EnzoPerrier/BancTestEL418-Electronique/CA/BANC_TEST_418/Note.txt

CHANGER TRANSISTOR COMMANDE BUZZER
ADM3232 à la place du MAX3232
