EnzoPerrier/BancTestEL418-Electronique/BANC_TEST_418-JLCPCB Assembly Order.xls

JLCPCB BOM Tool - BOM Matching
BOM name：BANC_TEST_418-JLCPCB Assembly Order.xlsx |  |  | Download Time：2025-05-28 04:37:29 |  |  |  | * Our matching results are updated in real-time, but stock and prices may change. If it's been over 24 hours, please re-match before placing your order.
PCB Assembled Qty：5 |  |  | Est. Total Price：3.9750
Your BOM |  |  |  |  | Matched Parts |  |  |  |  |  |  | Order Information
Top Designator | Bottom Designator | Comment | Footprint | JLCPCB Part # | Matches | Part # | Manufacturer | Footprint | Description | Category | Warning | JLCPCB Part # | Product link | Lib Type | Qty | Source | Total Price ($)
C1,C2 |  | 27pF | C0805_2012Metric_Pad1.18x1.45mm_HandSolder |  | Select by System | 0805CG270J500NT | FH (Guangdong Fenghua Advanced Tech) | 0805 | 50V 27pF C0G ±5% 0805 Multilayer Ceramic Capacitors MLCC - SMD/SMT ROHS | Multilayer Ceramic Capacitors MLCC - SMD/SMT |  | C1808 | https://jlcpcb.com/partdetail/2160-0805CG270J500NT/C1808 | Extended | 0 | 0 JLCPCB | 0
C3,C14,C16,C23,C24,C26,C27,C28,C29 |  | 100nF | C0805_2012Metric_Pad1.18x1.45mm_HandSolder |  | Select by System | CC0805KRX7R9BB104 | YAGEO | 0805 | 50V 100nF X7R ±10% 0805 Multilayer Ceramic Capacitors MLCC - SMD/SMT ROHS | Multilayer Ceramic Capacitors MLCC - SMD/SMT |  | C49678 | https://jlcpcb.com/partdetail/YAGEO-CC0805KRX7R9BB104/C49678 | Basic | 75 | 75 JLCPCB | 0.33
C4,C9,C15,C17,C18,C19 |  | 100nF | C0805_2012Metric_Pad1.18x1.45mm_HandSolder |  | Select by System | CC0805KRX7R9BB104 | YAGEO | 0805 | 50V 100nF X7R ±10% 0805 Multilayer Ceramic Capacitors MLCC - SMD/SMT ROHS | Multilayer Ceramic Capacitors MLCC - SMD/SMT |  | C49678 | https://jlcpcb.com/partdetail/YAGEO-CC0805KRX7R9BB104/C49678 | Basic | 75 | 75 JLCPCB | 0.33
C6 |  | 4.7uF | C0805_2012Metric_Pad1.18x1.45mm_HandSolder |  | Select by System | CL21A475KAQNNNE | Samsung Electro-Mechanics | 0805 | 25V 4.7uF X5R ±10% 0805 Multilayer Ceramic Capacitors MLCC - SMD/SMT ROHS | Multilayer Ceramic Capacitors MLCC - SMD/SMT |  | C1779 | https://jlcpcb.com/partdetail/2131-CL21A475KAQNNNE/C1779 | Basic | 5 | 5 JLCPCB | 0.0575
C7 |  | 470nF | C0805_2012Metric_Pad1.18x1.45mm_HandSolder |  | Select by System | CL21B474KBFNNNE | Samsung Electro-Mechanics | 0805 | 50V 470nF X7R ±10% 0805 Multilayer Ceramic Capacitors MLCC - SMD/SMT ROHS | Multilayer Ceramic Capacitors MLCC - SMD/SMT |  | C13967 | https://jlcpcb.com/partdetail/14623-CL21B474KBFNNNE/C13967 | Basic | 5 | 5 JLCPCB | 0.064
C10 |  | 47uF | C0805_2012Metric_Pad1.18x1.45mm_HandSolder |  | Select by System | CL21A476MQYNNNE | Samsung Electro-Mechanics | 0805 | 6.3V 47uF X5R ±20% 0805 Multilayer Ceramic Capacitors MLCC - SMD/SMT ROHS | Multilayer Ceramic Capacitors MLCC - SMD/SMT |  | C16780 | https://jlcpcb.com/partdetail/17464-CL21A476MQYNNNE/C16780 | Basic | 5 | 5 JLCPCB | 0.15
C11 |  | 1nF | C0805_2012Metric_Pad1.18x1.45mm_HandSolder |  | Select by System | CL21B102KBCNNNC | Samsung Electro-Mechanics | 0805 | 50V 1nF X7R ±10% 0805 Multilayer Ceramic Capacitors MLCC - SMD/SMT ROHS | Multilayer Ceramic Capacitors MLCC - SMD/SMT |  | C46653 | https://jlcpcb.com/partdetail/47657-CL21B102KBCNNNC/C46653 | Basic | 5 | 5 JLCPCB | 0.04
C12 |  | 47pF | C0805_2012Metric_Pad1.18x1.45mm_HandSolder |  | Select by System | CL21C470JBANNNC | Samsung Electro-Mechanics | 0805 | 50V 47pF C0G ±5% 0805 Multilayer Ceramic Capacitors MLCC - SMD/SMT ROHS | Multilayer Ceramic Capacitors MLCC - SMD/SMT |  | C14857 | https://jlcpcb.com/partdetail/15529-CL21C470JBANNNC/C14857 | Basic | 5 | 5 JLCPCB | 0.0555
C13 |  | 15nF | C0805_2012Metric_Pad1.18x1.45mm_HandSolder |  | Select by System | CC0805KRX7R9BB153 | YAGEO | 0805 | 50V 15nF X7R ±10% 0805 Multilayer Ceramic Capacitors MLCC - SMD/SMT ROHS | Multilayer Ceramic Capacitors MLCC - SMD/SMT |  | C107143 | https://jlcpcb.com/partdetail/YAGEO-CC0805KRX7R9BB153/C107143 | Extended | 0 | 0 JLCPCB | 0
C20,C21,C22,C25 |  | 1uF | C0805_2012Metric_Pad1.18x1.45mm_HandSolder |  | Select by System | CL21B105KBFNNNE | Samsung Electro-Mechanics | 0805 | 50V 1uF X7R ±10% 0805 Multilayer Ceramic Capacitors MLCC - SMD/SMT ROHS | Multilayer Ceramic Capacitors MLCC - SMD/SMT |  | C28323 | https://jlcpcb.com/partdetail/29074-CL21B105KBFNNNE/C28323 | Basic | 20 | 20 JLCPCB | 0.186
D1 |  | 1N4742A | D_DO-41_SOD81_P10.16mm_Horizontal |  | Select by System | 1N4742A | onsemi | 插件,D2.03xL4.06mm | Independent Type 11.4V~12.6V 1W 12V Plugin,D2.03xL4.06mm Zener Diodes ROHS | Zener Diodes |  | C140853 | https://jlcpcb.com/partdetail/onsemi-1N4742A/C140853 | Extended | 7 | 7 JLCPCB | 0.455
D2 |  | MBRA340 | D_SMA |  | Unconfirmed | MBRA340T3G | Tokmas | DO-214AC | 40V 450mV 3A DO-214AC Schottky Diodes ROHS | Schottky Diodes | 1.The comment (MBRA340T3G) of this part does not match the one (MBRA340) provided in your BOM. Please confirm; | C5337991 | https://jlcpcb.com/partdetail/Tokmas-MBRA340T3G/C5337991 | Extended | 0 | 0 JLCPCB | 0
D3,D6,D7,D8 |  | SM4007 | D_MELF |  | Select by System | SM4007 | YFW | DO-213AB | 1A 1V@1A 1000V 2uA@1000V DO-213AB Diodes - General Purpose | Diodes - General Purpose |  | C41433819 | https://jlcpcb.com/partdetail/YFW-SM4007/C41433819 | Extended | 0 | 0 JLCPCB | 0
D4 |  | PESD3V3L4UG | SOT-353_SC-70-5 |  | Select by System | PESD3V3L4UG | TECH PUBLIC | SOT-353 | SOT-353 ESD and Surge Protection (TVS/ESD) ROHS | ESD And Surge Protection (TVS/ESD) |  | C3021134 | https://jlcpcb.com/partdetail/TECHPUBLIC-PESD3V3L4UG/C3021134 | Extended | 0 | 0 JLCPCB | 0
JUMP1 |  | JUMPER | PinHeader_1x02_P1.00mm_Vertical |  | Unconfirmed | Jumper2 | Wurth Elektronik | HDR-TH_2P-P2.54-L5.1-W2.5 | Wurth Elektronik Jumper2 |  | 1.The comment (Jumper2) of this part does not match the one (JUMPER) provided in your BOM. Please confirm; | C2940092 | https://jlcpcb.com/partdetail/WurthElektronik-Jumper2/C2940092 | Extended | 0 | 0 JLCPCB | 0
Q1,Q3,Q4,Q5,Q6,Q7,Q9,Q10,Q11,Q12 |  | BSS138 | SOT95P240X111-3N |  | Select by System | BSS138 | hongjiacheng | SOT-23 | 50V 340mA 2.5Ω@10V,0.34A 350mW 1.6V@250uA 1PCSNChannel SOT-23 MOSFETs ROHS | MOSFETs |  | C7420339 | https://jlcpcb.com/partdetail/hongjiacheng-BSS138/C7420339 | Extended | 0 | 0 JLCPCB | 0
Q2 |  | IRF9540N | TO-263-2 |  | Unconfirmed | IRF9540NSTRLPBF | Infineon Technologies | D2PAK | 100V 23A 117mΩ@10V,14A 4V@250uA 1 Piece P-Channel D2PAK MOSFETs ROHS | MOSFETs | 1.The comment (IRF9540NSTRLPBF) of this part does not match the one (IRF9540N) provided in your BOM. Please confirm; | C33903 | https://jlcpcb.com/partdetail/InfineonTechnologies-IRF9540NSTRLPBF/C33903 | Extended | 0 | 0 JLCPCB | 0
Q8 |  | PS302 | LED_D5.0mm_Clear |  | Unconfirmed | 1PS302,115 | Nexperia | SOT-323 | 80V 1 pair in series 1.2V@100mA 4ns 200mA SOT-323 Switching Diodes ROHS | Switching Diodes | 1.The comment (1PS302,115) of this part does not match the one (PS302) provided in your BOM. Please confirm; | C192740 | https://jlcpcb.com/partdetail/Nexperia-1PS302115/C192740 | Extended | 0 | 0 JLCPCB | 0
R1,R2,R3,R5,R6,R7,R21,R24,R28,R31 |  | 10k | R0805_2012Metric_Pad1.20x1.40mm_HandSolder |  | Unconfirmed | 0805W8F1002T5E | UNI-ROYAL(Uniroyal Elec) | 0805 | 125mW Thick Film Resistors 150V ±100ppm/℃ ±1% 10kΩ 0805 Chip Resistor - Surface Mount ROHS | Chip Resistor - Surface Mount | 1.The comment (0805W8F1002T5E) of this part does not match the one (10k) provided in your BOM. Please confirm; | C17414 | https://jlcpcb.com/partdetail/18102-0805W8F1002T5E/C17414 | Basic | 50 | 50 JLCPCB | 0.085
R4,R8 |  | 4.7k | R0805_2012Metric_Pad1.20x1.40mm_HandSolder |  | Unconfirmed | 0805W8F4701T5E | UNI-ROYAL(Uniroyal Elec) | 0805 | 125mW Thick Film Resistors 150V ±100ppm/℃ ±1% 4.7kΩ 0805 Chip Resistor - Surface Mount ROHS | Chip Resistor - Surface Mount | 1.The comment (0805W8F4701T5E) of this part does not match the one (4.7k) provided in your BOM. Please confirm; 2.Multiple lines in the BOM have been matched to the same part. Please check if the matching is correct. ; | C17673 | https://jlcpcb.com/partdetail/18361-0805W8F4701T5E/C17673 | Basic | 15 | 15 JLCPCB | 0.0255
R9 |  | 4k7 | R0805_2012Metric_Pad1.20x1.40mm_HandSolder |  | Unconfirmed | 0805W8F4701T5E | UNI-ROYAL(Uniroyal Elec) | 0805 | 125mW Thick Film Resistors 150V ±100ppm/℃ ±1% 4.7kΩ 0805 Chip Resistor - Surface Mount ROHS | Chip Resistor - Surface Mount | 1.The comment (0805W8F4701T5E) of this part does not match the one (4k7) provided in your BOM. Please confirm; 2.Multiple lines in the BOM have been matched to the same part. Please check if the matching is correct. ; | C17673 | https://jlcpcb.com/partdetail/18361-0805W8F4701T5E/C17673 | Basic | 15 | 15 JLCPCB | 0.0255
R10,R17,R18,R32,R33,R34,R35,R36,R37,R38,R41,R47,R48,R49,R50 |  | 100 | R0805_2012Metric_Pad1.20x1.40mm_HandSolder |  | Unconfirmed | 0805W8F1000T5E | UNI-ROYAL(Uniroyal Elec) | 0805 | 125mW Thick Film Resistors 150V ±100ppm/℃ ±1% 100Ω 0805 Chip Resistor - Surface Mount ROHS | Chip Resistor - Surface Mount | 1.The comment (0805W8F1000T5E) of this part does not match the one (100) provided in your BOM. Please confirm; | C17408 | https://jlcpcb.com/partdetail/18096-0805W8F1000T5E/C17408 | Basic | 75 | 75 JLCPCB | 0.135
R11 |  | 332k1% | R0805_2012Metric_Pad1.20x1.40mm_HandSolder |  | Unconfirmed | FRC0805F3323TS | FOJAN | 0805 | 125mW Thick Film Resistors 150V ±100ppm/℃ ±1% 332kΩ 0805 Chip Resistor - Surface Mount ROHS | Chip Resistor - Surface Mount | 1.The comment (FRC0805F3323TS) of this part does not match the one (332k1%) provided in your BOM. Please confirm; | C5713304 | https://jlcpcb.com/partdetail/FOJAN-FRC0805F3323TS/C5713304 | Extended | 0 | 0 JLCPCB | 0
R12 |  | 68.1k1% | R0805_2012Metric_Pad1.20x1.40mm_HandSolder |  | Unconfirmed | ARG05FTC6812 | Viking Tech | 0805 | 125mW Thin Film Resistor 150V ±25ppm/℃ ±1% 68.1kΩ 0805 Chip Resistor - Surface Mount ROHS | Chip Resistor - Surface Mount | 1.The comment (ARG05FTC6812) of this part does not match the one (68.1k1%) provided in your BOM. Please confirm; | C2831652 | https://jlcpcb.com/partdetail/VikingTech-ARG05FTC6812/C2831652 | Extended | 0 | 0 JLCPCB | 0
R13 |  | 220 | R0805_2012Metric_Pad1.20x1.40mm_HandSolder |  | Unconfirmed | 0805W8F2200T5E | UNI-ROYAL(Uniroyal Elec) | 0805 | 125mW Thick Film Resistors 150V ±100ppm/℃ ±1% 220Ω 0805 Chip Resistor - Surface Mount ROHS | Chip Resistor - Surface Mount | 1.The comment (0805W8F2200T5E) of this part does not match the one (220) provided in your BOM. Please confirm; | C17557 | https://jlcpcb.com/partdetail/18245-0805W8F2200T5E/C17557 | Basic | 5 | 5 JLCPCB | 0.0095
R14 |  | 10.2k1% | R0805_2012Metric_Pad1.20x1.40mm_HandSolder |  | Unconfirmed | FRC0805F1022TS | FOJAN | 0805 | 125mW Thick Film Resistors 150V ±100ppm/℃ ±1% 10.2kΩ 0805 Chip Resistor - Surface Mount ROHS | Chip Resistor - Surface Mount | 1.The comment (FRC0805F1022TS) of this part does not match the one (10.2k1%) provided in your BOM. Please confirm; | C2933282 | https://jlcpcb.com/partdetail/FOJAN-FRC0805F1022TS/C2933282 | Extended | 0 | 0 JLCPCB | 0
R15 |  | 3.24k1% | R0805_2012Metric_Pad1.20x1.40mm_HandSolder |  | Unconfirmed | FRC0805F3241TS | FOJAN | 0805 | 125mW Thick Film Resistors 150V ±100ppm/℃ ±1% 3.24kΩ 0805 Chip Resistor - Surface Mount ROHS | Chip Resistor - Surface Mount | 1.The comment (FRC0805F3241TS) of this part does not match the one (3.24k1%) provided in your BOM. Please confirm; | C2933414 | https://jlcpcb.com/partdetail/FOJAN-FRC0805F3241TS/C2933414 | Extended | 0 | 0 JLCPCB | 0
R16 |  | 29.4k | R0805_2012Metric_Pad1.20x1.40mm_HandSolder |  | Unconfirmed | FRC0805F2942TS | FOJAN | 0805 | 125mW Thick Film Resistors 150V ±100ppm/℃ ±1% 29.4kΩ 0805 Chip Resistor - Surface Mount ROHS | Chip Resistor - Surface Mount | 1.The comment (FRC0805F2942TS) of this part does not match the one (29.4k) provided in your BOM. Please confirm; | C5121537 | https://jlcpcb.com/partdetail/FOJAN-FRC0805F2942TS/C5121537 | Extended | 0 | 0 JLCPCB | 0
R19,R20,R22,R23,R26,R27,R29,R30 |  | 200 | R0805_2012Metric_Pad1.20x1.40mm_HandSolder |  | Unconfirmed | 0805W8F2000T5E | UNI-ROYAL(Uniroyal Elec) | 0805 | 125mW Thick Film Resistors 150V ±100ppm/℃ ±1% 200Ω 0805 Chip Resistor - Surface Mount ROHS | Chip Resistor - Surface Mount | 1.The comment (0805W8F2000T5E) of this part does not match the one (200) provided in your BOM. Please confirm; | C17540 | https://jlcpcb.com/partdetail/18228-0805W8F2000T5E/C17540 | Basic | 40 | 40 JLCPCB | 0.072
R25 |  | 68 | R0805_2012Metric_Pad1.20x1.40mm_HandSolder |  | Unconfirmed | 0805W8F680JT5E | UNI-ROYAL(Uniroyal Elec) | 0805 | 125mW Thick Film Resistors 150V ±1% ±200ppm/℃ 68Ω 0805 Chip Resistor - Surface Mount ROHS | Chip Resistor - Surface Mount | 1.The comment (0805W8F680JT5E) of this part does not match the one (68) provided in your BOM. Please confirm; | C17802 | https://jlcpcb.com/partdetail/18490-0805W8F680JT5E/C17802 | Extended | 0 | 0 JLCPCB | 0
R39 |  | 120 | R0805_2012Metric_Pad1.20x1.40mm_HandSolder |  | Unconfirmed | 0805W8F1200T5E | UNI-ROYAL(Uniroyal Elec) | 0805 | 125mW Thick Film Resistors 150V ±100ppm/℃ ±1% 120Ω 0805 Chip Resistor - Surface Mount ROHS | Chip Resistor - Surface Mount | 1.The comment (0805W8F1200T5E) of this part does not match the one (120) provided in your BOM. Please confirm; | C17437 | https://jlcpcb.com/partdetail/18125-0805W8F1200T5E/C17437 | Basic | 5 | 5 JLCPCB | 0.009
R40 |  | 47k | R0805_2012Metric_Pad1.20x1.40mm_HandSolder |  | Unconfirmed | 0805W8F4702T5E | UNI-ROYAL(Uniroyal Elec) | 0805 | 125mW Thick Film Resistors 150V ±100ppm/℃ ±1% 47kΩ 0805 Chip Resistor - Surface Mount ROHS | Chip Resistor - Surface Mount | 1.The comment (0805W8F4702T5E) of this part does not match the one (47k) provided in your BOM. Please confirm; | C17713 | https://jlcpcb.com/partdetail/18401-0805W8F4702T5E/C17713 | Basic | 5 | 5 JLCPCB | 0.009
R42 |  | 0.11% | R_2512_6332Metric_Pad1.40x3.35mm_HandSolder |  | Unconfirmed | RMC040230.11%N | TyoHM | 0402 | 62.5mW ±1% 30.1Ω 0402 Chip Resistor - Surface Mount ROHS | Chip Resistor - Surface Mount | 1.The comment (RMC040230.11%N) of this part does not match the one (0.11%) provided in your BOM. Please confirm; | C269647 | https://jlcpcb.com/partdetail/TyoHM-RMC040230_11N/C269647 | Extended | 0 | 0 JLCPCB | 0
R43,R44,R45 |  | 500 | R0805_2012Metric_Pad1.20x1.40mm_HandSolder |  | Unconfirmed | ARG05FTC5000 | Viking Tech | 0805 | 125mW Thin Film Resistor 150V ±25ppm/℃ ±1% 500Ω 0805 Chip Resistor - Surface Mount ROHS | Chip Resistor - Surface Mount | 1.The comment (ARG05FTC5000) of this part does not match the one (500) provided in your BOM. Please confirm; | C2828857 | https://jlcpcb.com/partdetail/VikingTech-ARG05FTC5000/C2828857 | Extended | 0 | 0 JLCPCB | 0
R46 |  | 470 | R0805_2012Metric_Pad1.20x1.40mm_HandSolder |  | Unconfirmed | 0805W8F4700T5E | UNI-ROYAL(Uniroyal Elec) | 0805 | 125mW Thick Film Resistors 150V ±100ppm/℃ ±1% 470Ω 0805 Chip Resistor - Surface Mount ROHS | Chip Resistor - Surface Mount | 1.The comment (0805W8F4700T5E) of this part does not match the one (470) provided in your BOM. Please confirm; | C17710 | https://jlcpcb.com/partdetail/18398-0805W8F4700T5E/C17710 | Basic | 5 | 5 JLCPCB | 0.009
U1 |  | STM32F103C8Tx | LQFP-48_7x7mm_P0.5mm |  | Select by System | STM32F103C8T6 | STMicroelectronics | LQFP-48(7x7) | 64KB 2V~3.6V ARM-M3 20KB 72MHz FLASH 37 LQFP-48(7x7) Microcontrollers (MCU/MPU/SOC) ROHS | Microcontrollers (MCU/MPU/SOC) |  | C8734 | https://jlcpcb.com/partdetail/STMicroelectronics-STM32F103C8T6/C8734 | Extended | 0 | 0 JLCPCB | 0
U2 |  | TPS3825-33QDBVRQ1 | TPS3825-SOT95P280X145-5N |  | Select by System | TPS3825-33QDBVRQ1 | Texas Instruments | SOT-23-5 | 120ms Active Low 1 SOT-23-5 Supervisor and Reset ICs ROHS | Supervisor And Reset ICs |  | C702194 | https://jlcpcb.com/partdetail/TexasInstruments-TPS382533QDBVRQ1/C702194 | Extended | 0 | 0 JLCPCB | 0
U6 |  | MAX3485 | SOIC-8_3.9x4.9mm_P1.27mm |  | Unconfirmed | MAX3485EIM/TR | HGSEMI | SOP-8 | SOP-8 RS-485 / RS-422 ICs ROHS | RS-485 / RS-422 ICs | 1.The comment (MAX3485EIM/TR) of this part does not match the one (MAX3485) provided in your BOM. Please confirm; | C519082 | https://jlcpcb.com/partdetail/HGSEMI-MAX3485EIMTR/C519082 | Extended | 0 | 0 JLCPCB | 0
U7 |  | MAX3232 | SOIC-16W_7.5x10.3mm_P1.27mm |  | Unconfirmed | MAX3232ESE+T | Analog Devices Inc./Maxim Integrated | SOIC-16 | 250Kbps Transceiver 2/2 SOIC-16 RS232 ICs ROHS | RS232 ICs | 1.The comment (MAX3232ESE+T) of this part does not match the one (MAX3232) provided in your BOM. Please confirm; | C15846 | https://jlcpcb.com/partdetail/16528-MAX3232ESET/C15846 | Extended | 0 | 0 JLCPCB | 0
Y1 |  | ABL-8.000MHZ-B2 | Crystal_SMD_HC49-SD_HandSoldering |  | Select by System | ABL-8.000MHZ-B2 | Abracon LLC | HC-49US | 8MHz 18pF ±20ppm ±50ppm HC-49US Crystals ROHS | Crystals |  | C7060573 | https://jlcpcb.com/partdetail/AbraconLLC-ABL_8_000MHZB2/C7060573 | Extended | 5 | 5 JLCPCB | 1.9275
C5 |  | 470uF | C_Elec_10x10.2 |  | Select by System | 470uF | HEADCON | 470uF-16V 6.3x8mm | HEADCON 470uF |  |  | C22383481 | https://jlcpcb.com/partdetail/HEADCON-470uF/C22383481 | Extended | 5 | 0 JLCPCB | 0
C8 |  | 100uF | C_Elec_10x10.2 |  | Select by System | 100uF | PANASONIC | CAP-SMD | PANASONIC 100uF |  |  | C20618601 | https://jlcpcb.com/partdetail/PANASONIC-100uF/C20618601 | Extended | 5 | 0 JLCPCB | 0
D9,D10 |  | SMAJ5.0CA | D_SMA |  | Select by System | SMAJ5.0CA | RealChip | SMA(DO-214AC) | RealChip SMAJ5.0CA |  |  | C6937207 | https://jlcpcb.com/partdetail/RealChip-SMAJ50CA/C6937207 | Extended | 12 | 0 JLCPCB | 0
K1,K2,K3,K4 |  | RT314A12 | Relay_SPDT_Schrack-RT1-16A-FormC_RM5mm |  | Select by System | RT314A12 | TE Connectivity | 插件 | 16A 400V@AC 12V SPDT (1 Form C) Plugin Magnetic Latching Relays ROHS | Magnetic Latching Relays |  | C1562830 | https://jlcpcb.com/partdetail/TEConnectivity-RT314A12/C1562830 | Extended | 20 | 0 JLCPCB | 0
U3 |  | TPS54231DRG4 | SOIC127P599X175-8N |  | Select by System | TPS54231DRG4 | Texas Instruments | SOIC-8 | Step-down type Adjustable 800mV~25V 2A 3.5V~28V SOIC-8 DC-DC Converters ROHS | DC-DC Converters |  | C3199747 | https://jlcpcb.com/partdetail/TexasInstruments-TPS54231DRG4/C3199747 | Extended | 5 | 0 JLCPCB | 0
U4,U5 |  | TCMT4106 | SOP-16_4.4x10.4mm_P1.27mm |  | Select by System | TCMT4106 | Vishay Intertech | SOIC-16 | SOIC-16 Transistor, Photovoltaic Output Optoisolators ROHS | Transistor, Photovoltaic Output Optoisolators |  | C5722208 | https://jlcpcb.com/partdetail/VishayIntertech-TCMT4106/C5722208 | Extended | 10 | 0 JLCPCB | 0
U8 |  | HTU21D | QFN100P300X300X100-7N |  | Select by System | HTU21D | TE Connectivity | DFN-6-EP(3x3) | DFN-6-EP(3x3) Temperature and Humidity Sensor ROHS | Temperature And Humidity Sensor |  | C83479 | https://jlcpcb.com/partdetail/TEConnectivity-HTU21D/C83479 | Extended | 5 | 0 JLCPCB | 0
BZ1 |  | Buzzer | Buzzer_15x7.5RM7.6 |  | No matches | No Part Selected
D5 |  | LEDVerte5mm | LED_D5.0mm |  | No matches | No Part Selected
J1 |  | Conn_01x10_Pin | PinHeader_1x10_P2.54mm_Vertical |  | No matches | No Part Selected
J2 |  | Conn_01x04_Pin | PhoenixContact_MCV_1,5_4-G-3.81_1x04_P3.81mm_Vertical |  | No matches | No Part Selected
J3 |  | Conn_01x08_Pin | PhoenixContact_MCV_1,5_8-G-3.81_1x08_P3.81mm_Vertical |  | No matches | No Part Selected
J4,J5 |  | Conn_01x06_Pin | PhoenixContact_MCV_1,5_6-G-3.81_1x06_P3.81mm_Vertical |  | No matches | No Part Selected
J6 |  | Conn_01x11_Pin_418 | PhoenixContact_MSTBVA_2,5_11-G-5,08_1x11_P5.08mm_Vertical |  | No matches | No Part Selected
J7,J11 |  | Conn_01x05_Pin | PhoenixContact_MCV_1,5_5-G-3.81_1x05_P3.81mm_Vertical |  | No matches | No Part Selected
J8 |  | DE9_Socket | DSUB-9_Socket_Horizontal_P2.77x2.84mm_EdgePinOffset9.40mm |  | No matches | No Part Selected
J9 |  | Conn_01x09_Pin_418 | PhoenixContact_MCV_1,5_9-G-3.81_1x09_P3.81mm_Vertical |  | No matches | No Part Selected
J10 |  | Conn_01x04_Pin | NS-Tech_Grove_1x04_P2mm_Vertical |  | No matches | No Part Selected
L1 |  | 10uH | L_Coilcraft_MSS1260-XXX |  | No matches | No Part Selected
SW1 |  | SW_DIP_x01 | SW_DIP_SPSTx01_Slide_9.78x4.72mm_W8.61mm_P2.54mm |  | No matches | No Part Selected
SW2 |  | SW_DIP_x03 | SW_DIP_SPSTx03_Slide_Omron_A6S-310x_W8.9mm_P2.54mm |  | No matches | No Part Selected
SW3 |  | SW_Push | SW_SPST_Omron_B3FS-100xP |  | No matches | No Part Selected
U9 |  | INA219AxDCN | SOT-23-8 |  | No matches | No Part Selected
