EnzoPerrier/BancTestEL418-Electronique/CA/Archives/BANC_TEST_418_V1/Note.txt

Rs232 (MAX232) : les condensateurs sont des charges pompes et permettent de creer du +/-12V grâce à du 5V

MAX485: DE = HIGH et RE = LOW permettent l'émission des données
	DE = LOW et RE = LOW permettent la réception des données

L1: Prendre coilcraft MSS1260-103NLD https://www.coilcraft.com/en-us/products/power/shielded-inductors/ferrite-drum/mss-mos/mss1260/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
C4 (condo polarisé): https://fr.rs-online.com/web/p/condensateurs-electrolytiques-aluminium/5370528?gb=s
R42 (résistance de shunt):https://www.mouser.fr/ProductDetail/Ohmite/LVM25FVR100E-TR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

Clock: https://www.mouser.fr/datasheet/2/3/abls-1664338.pdf
