EnzoPerrier/BancTestEL418-Electronique/CA/BANC_TEST_418/BANC_TEST_418.kicad_pcb

## KiCad design CA/BANC_TEST_418/BANC_TEST_418.kicad_pcb (2025-11-05)

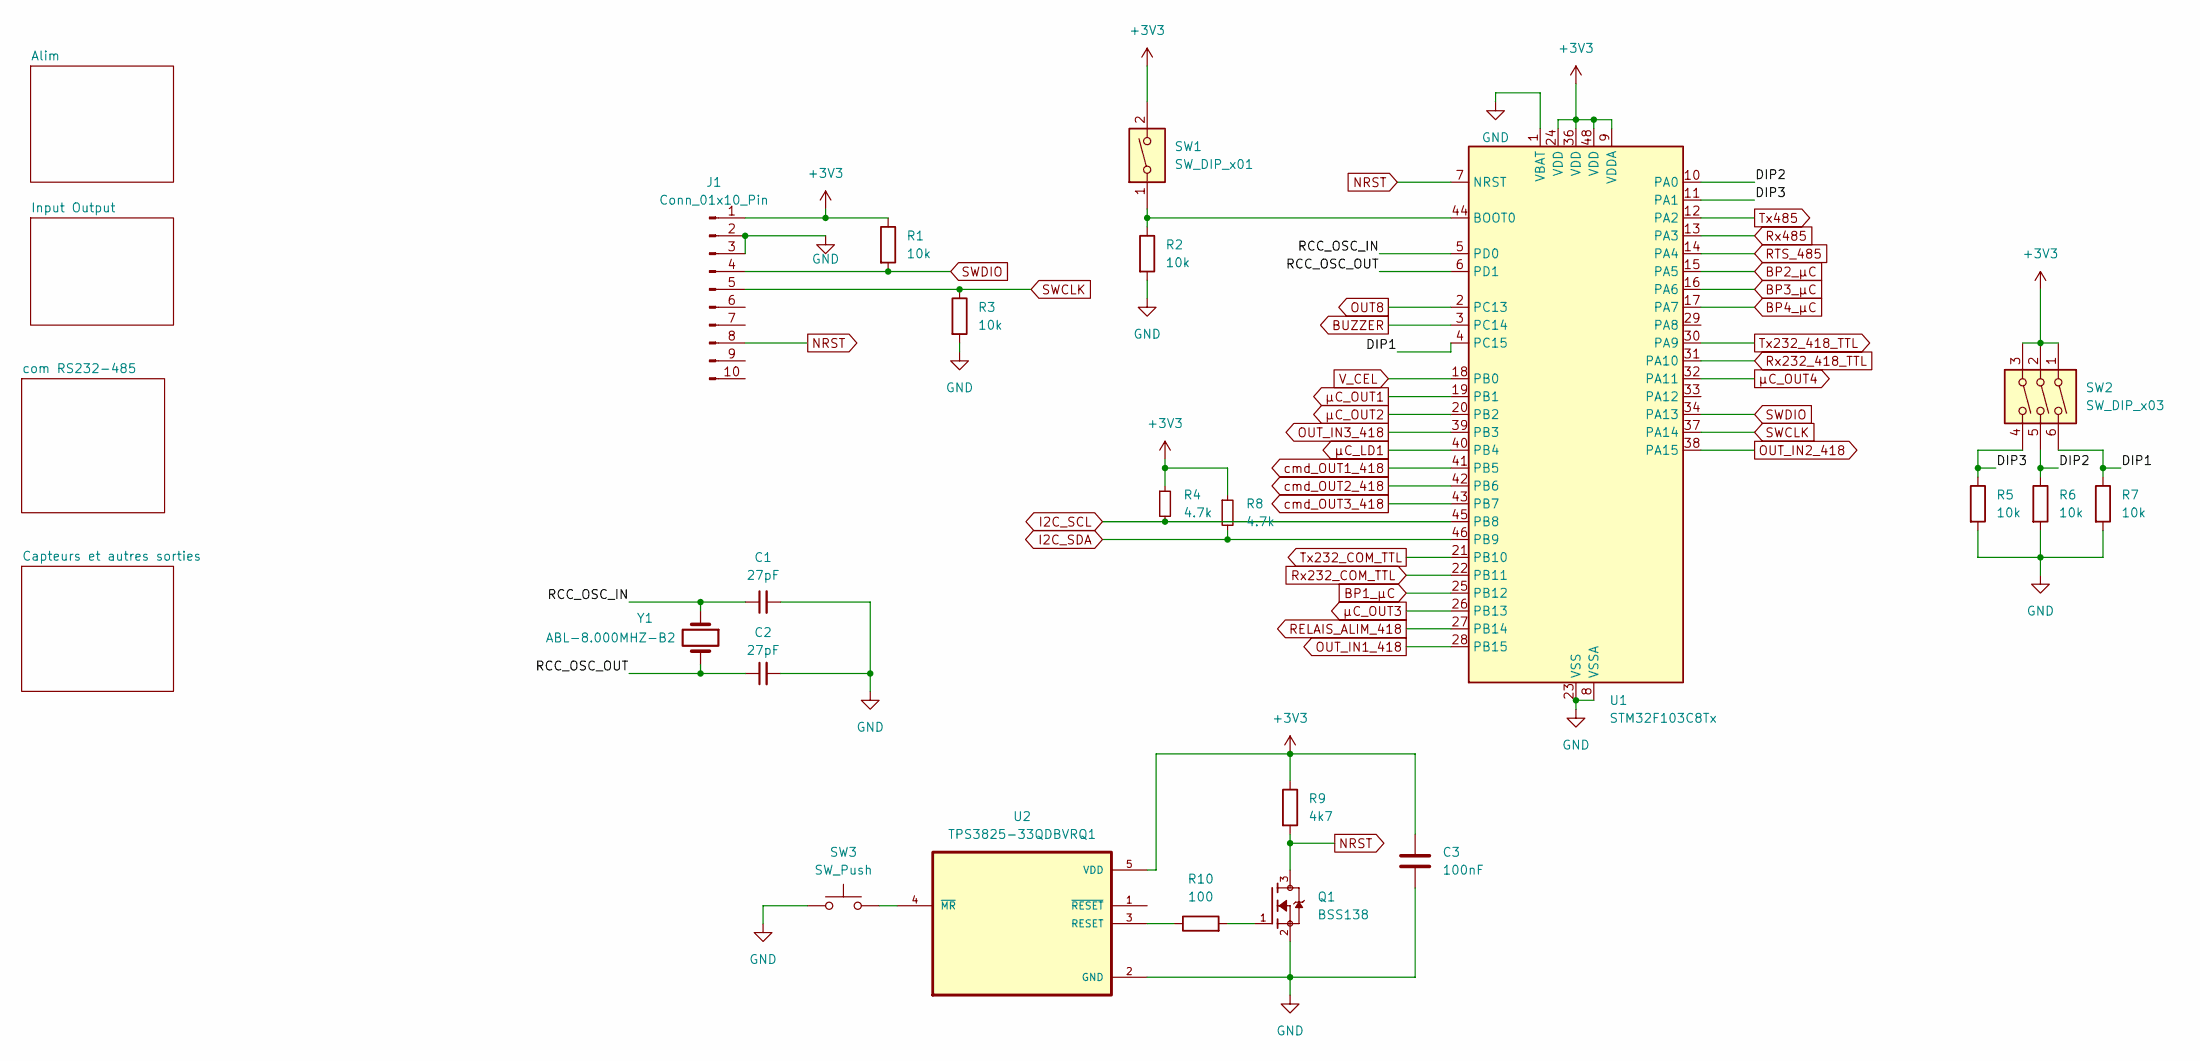
[picture p32: schematic BANC_TEST_418.kicad_sch, MAIN MCU]

Parts:
C1, C2: 27pF; C_0805_2012Metric_Pad1.18x1.45mm_HandSolder
C3: 100nF; C_0805_2012Metric_Pad1.18x1.45mm_HandSolder
J1: Conn_01x10_Pin; PinHeader_1x10_P2.54mm_Vertical
Q1: BSS138; SOT95P240X111-3N; PARTREV 30 Jan 2018
R1, R2, R3, R5, R6, R7: 10k; R_0805_2012Metric_Pad1.20x1.40mm_HandSolder
R4, R8: 4.7k; R_0805_2012Metric_Pad1.20x1.40mm_HandSolder
R9: 4k7; R_0805_2012Metric_Pad1.20x1.40mm_HandSolder
R10: 100; R_0805_2012Metric_Pad1.20x1.40mm_HandSolder
SW1: SW_DIP_x01; SW_DIP_SPSTx01_Slide_9.78x4.72mm_W8.61mm_P2.54mm
SW2: SW_DIP_x03; SW_DIP_SPSTx03_Slide_Omron_A6S-310x_W8.9mm_P2.54mm
SW3: SW_Push; SW_SPST_Omron_B3FS-100xP
U1: STM32F103C8Tx; LQFP-48_7x7mm_P0.5mm
U2: TPS3825-33QDBVRQ1; TPS3825-SOT95P280X145-5N
Y1: ABL-8.000MHZ-B2; Crystal_SMD_HC49-SD

Connections:
+3V3: C3.1, J1.1, R1.1, R4.1, R8.1, R9.1, SW1.2, SW2.1, SW2.2, SW2.3, U1.9 (VDDA), U1.24 (VDD), U1.36 (VDD), U1.48 (VDD), U2.5 (VDD); also elsewhere on the board
/DIP1: R7.1, SW2.6, U1.4 (PC15)
/DIP2: R6.1, SW2.5, U1.10 (PA0)
/DIP3: R5.1, SW2.4, U1.11 (PA1)
/RCC_OSC_IN: C1.1, U1.5 (PD0), Y1.1
/RCC_OSC_OUT: C2.1, U1.6 (PD1), Y1.2
BP1_µC: U1.25 (PB12); also elsewhere on the board
BP2_µC: U1.15 (PA5); also elsewhere on the board
BP3_µC: U1.16 (PA6); also elsewhere on the board
BP4_µC: U1.17 (PA7); also elsewhere on the board
BUZZER: U1.3 (PC14); also elsewhere on the board
GND: C1.2, C2.2, C3.2, J1.2, J1.3, Q1.2, R2.2, R3.2, R5.2, R6.2, R7.2, SW3.1, U1.1 (VBAT), U1.8 (VSSA), U1.23 (VSS), U1.35 (VSS), U1.47 (VSS), U2.2 (GND); also elsewhere on the board
I2C_SCL: R4.2, U1.45 (PB8); also elsewhere on the board
I2C_SDA: R8.2, U1.46 (PB9); also elsewhere on the board
NRST: J1.8, Q1.3, R9.2, U1.7 (NRST)
unnamed: Q1.1, R10.2
unnamed: R2.1, SW1.1, U1.44 (BOOT0)
unnamed: R10.1, U2.3 (RESET)
unnamed: SW3.2, U2.4 (~MR)
OUT8: U1.2 (PC13)
OUT_IN1_418: U1.28 (PB15); also elsewhere on the board
OUT_IN2_418: U1.38 (PA15); also elsewhere on the board
OUT_IN3_418: U1.39 (PB3); also elsewhere on the board
RELAIS_ALIM_418: U1.27 (PB14); also elsewhere on the board
RTS_485: U1.14 (PA4); also elsewhere on the board
Rx232_418_TTL: U1.31 (PA10); also elsewhere on the board
Rx232_COM_TTL: U1.22 (PB11); also elsewhere on the board
Rx485: U1.13 (PA3); also elsewhere on the board
SWCLK: J1.5, R3.1, U1.37 (PA14)
SWDIO: J1.4, R1.2, U1.34 (PA13)
Tx232_418_TTL: U1.30 (PA9); also elsewhere on the board
Tx232_COM_TTL: U1.21 (PB10); also elsewhere on the board
Tx485: U1.12 (PA2); also elsewhere on the board
V_CEL: U1.18 (PB0); also elsewhere on the board
cmd_OUT1_418: U1.41 (PB5); also elsewhere on the board
cmd_OUT2_418: U1.42 (PB6); also elsewhere on the board
cmd_OUT3_418: U1.43 (PB7); also elsewhere on the board
µC_LD1: U1.40 (PB4); also elsewhere on the board
µC_OUT1: U1.19 (PB1); also elsewhere on the board
µC_OUT2: U1.20 (PB2); also elsewhere on the board
µC_OUT3: U1.26 (PB13); also elsewhere on the board
µC_OUT4: U1.32 (PA11); also elsewhere on the board

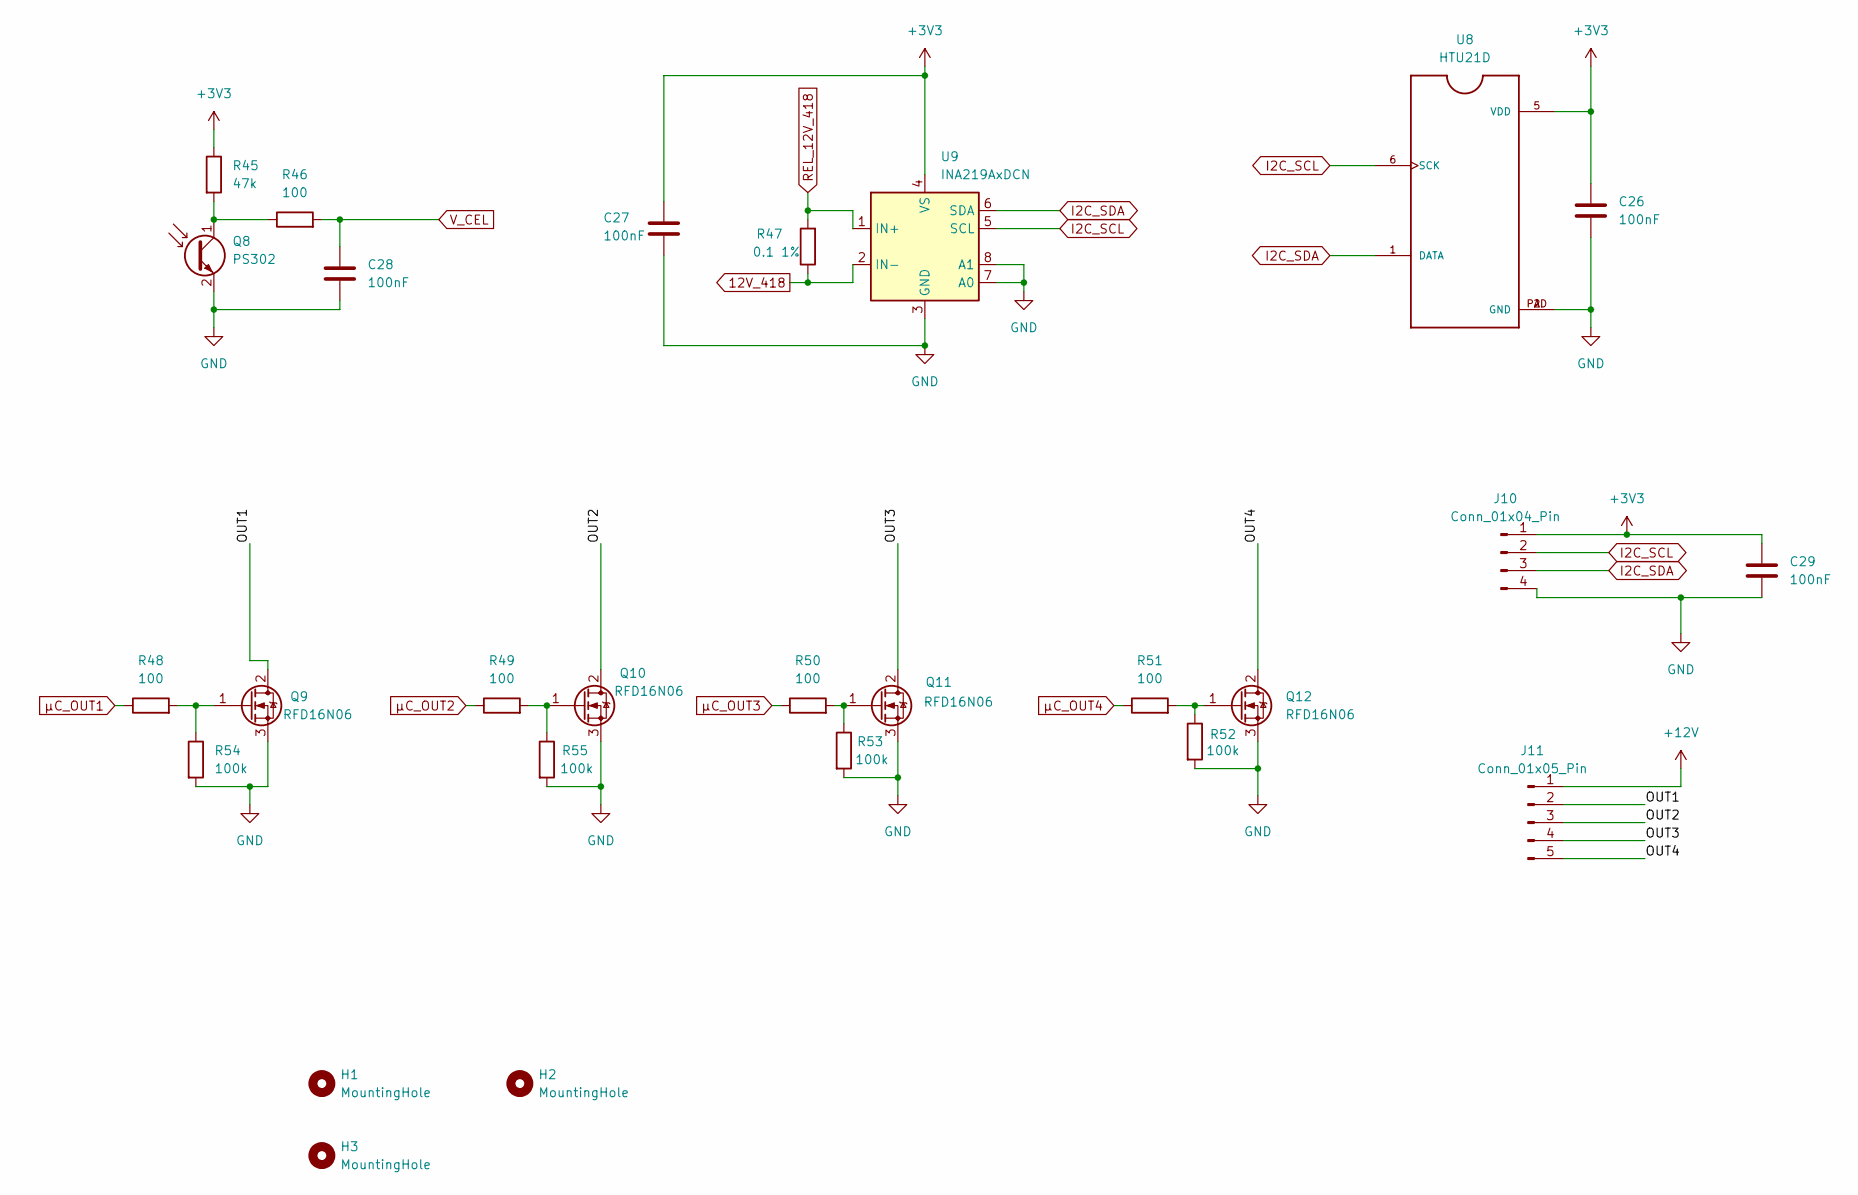
[picture p33: schematic capteurs.kicad_sch, Capteurs et autres sorties]

Parts:
C26, C27, C28, C29: 100nF; C_0805_2012Metric_Pad1.18x1.45mm_HandSolder
H1, H2, H3: MountingHole; MountingHole_4.3mm_M4_Pad
J10: Conn_01x04_Pin; NS-Tech_Grove_1x04_P2mm_Vertical
J11: Conn_01x05_Pin; PhoenixContact_MCV_1,5_5-G-3.81_1x05_P3.81mm_Vertical
Q8: PS302; LED_D5.0mm_Clear
Q9, Q10, Q11, Q12: RFD16N06; TO-252-2
R45: 47k; R_0805_2012Metric_Pad1.20x1.40mm_HandSolder
R46, R48, R49, R50, R51: 100; R_0805_2012Metric_Pad1.20x1.40mm_HandSolder
R47: 0.1 1%; R_2512_6332Metric_Pad1.40x3.35mm_HandSolder
R52, R53, R54, R55: 100k; R_0805_2012Metric_Pad1.20x1.40mm_HandSolder
U8: HTU21D; QFN100P300X300X100-7N
U9: INA219AxDCN; SOT-23-8

Connections:
12V_418: R47.1, U9.2 (IN-); also elsewhere on the board
+3V3: C26.1, C27.1, C29.1, J10.1, R45.1, U8.5 (VDD), U9.4 (VS); also elsewhere on the board
+12V: J11.1; also elsewhere on the board
/Capteurs et autres sorties/OUT1: J11.2, Q9.2 (D)
/Capteurs et autres sorties/OUT2: J11.3, Q10.2 (D)
/Capteurs et autres sorties/OUT3: J11.4, Q11.2 (D)
/Capteurs et autres sorties/OUT4: J11.5, Q12.2 (D)
GND: C26.2, C27.2, C28.2, C29.2, J10.4, Q8.2 (E), Q9.3 (S), Q10.3 (S), Q11.3 (S), Q12.3 (S), R52.2, R53.2, R54.2, R55.2, U8.2 (GND), U8.PAD (GND), U9.3 (GND), U9.7 (A0), U9.8 (A1); also elsewhere on the board
I2C_SCL: J10.2, U8.6 (SCK), U9.5 (SCL); also elsewhere on the board
I2C_SDA: J10.3, U8.1 (DATA), U9.6 (SDA); also elsewhere on the board
unnamed: Q8.1 (C), R45.2, R46.1
unnamed: Q9.1 (G), R48.2, R54.1
unnamed: Q10.1 (G), R49.2, R55.1
unnamed: Q11.1 (G), R50.2, R53.1
unnamed: Q12.1 (G), R51.2, R52.1
REL_12V_418: R47.2, U9.1 (IN+); also elsewhere on the board
V_CEL: C28.1, R46.2; also elsewhere on the board
µC_OUT1: R48.1; also elsewhere on the board
µC_OUT2: R49.1; also elsewhere on the board
µC_OUT3: R50.1; also elsewhere on the board
µC_OUT4: R51.1; also elsewhere on the board

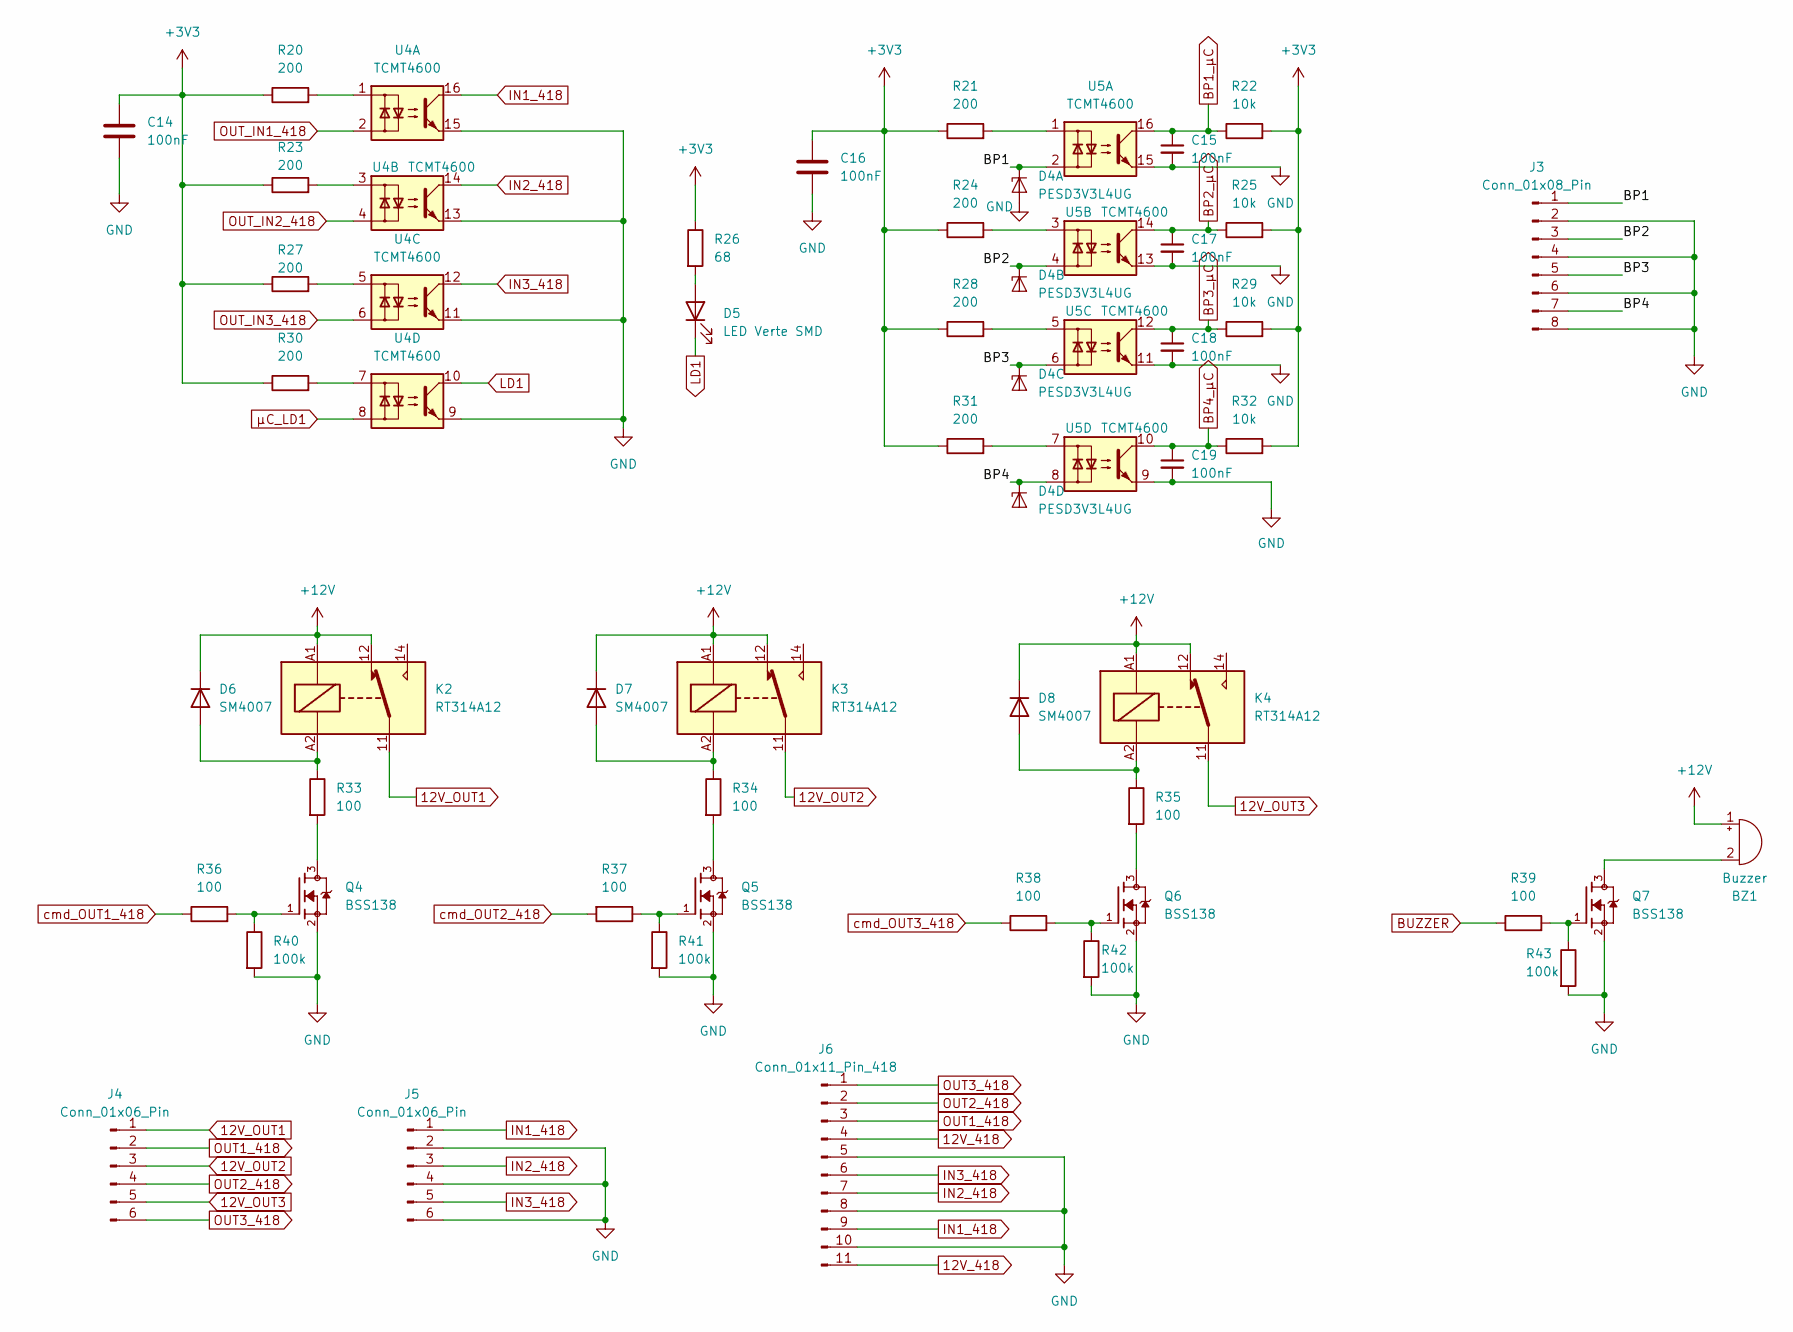
[picture p34: schematic InputOutput.kicad_sch, INPUT/OUTPUT]

Parts:
BZ1: Buzzer; Buzzer_15x7.5RM7.6
C14, C15, C16, C17, C18, C19: 100nF; C_0805_2012Metric_Pad1.18x1.45mm_HandSolder
D4: PESD3V3L4UG; SOT-353_SC-70-5
D5: LED Verte SMD; LED_0805_2012Metric_Pad1.15x1.40mm_HandSolder
D6, D7, D8: SM4007; D_MELF
J3: Conn_01x08_Pin; PhoenixContact_MCV_1,5_8-G-3.81_1x08_P3.81mm_Vertical
J4, J5: Conn_01x06_Pin; PhoenixContact_MCV_1,5_6-G-3.81_1x06_P3.81mm_Vertical
J6: Conn_01x11_Pin_418; PhoenixContact_MSTBVA_2,5_11-G-5,08_1x11_P5.08mm_Vertical
K2, K3, K4: RT314A12; Relay_SPDT_Schrack-RT1-16A-FormC_RM5mm
Q4, Q5, Q6, Q7: BSS138; SOT95P240X111-3N; PARTREV 30 Jan 2018
R20, R21, R23, R24, R27, R28, R30, R31: 200; R_0805_2012Metric_Pad1.20x1.40mm_HandSolder
R22, R25, R29, R32: 10k; R_0805_2012Metric_Pad1.20x1.40mm_HandSolder
R26: 68; R_0805_2012Metric_Pad1.20x1.40mm_HandSolder
R33, R34, R35, R36, R37, R38, R39: 100; R_0805_2012Metric_Pad1.20x1.40mm_HandSolder
R40, R41, R42, R43: 100k; R_0805_2012Metric_Pad1.20x1.40mm_HandSolder
U4, U5: TCMT4600; SOP-16_4.55x10.3mm_P1.27mm

Connections:
12V_418: J6.4, J6.11; also elsewhere on the board
12V_OUT1: J4.1, K2.11
12V_OUT2: J4.3, K3.11
12V_OUT3: J4.5, K4.11
+3V3: C14.1, C16.1, R20.1, R21.1, R22.2, R23.1, R24.1, R25.2, R26.1, R27.1, R28.1, R29.2, R30.1, R31.1, R32.2; also elsewhere on the board
+12V: BZ1.1 (+), D6.1 (K), D7.1 (K), D8.1 (K), K2.12, K2.A1, K3.12, K3.A1, K4.12, K4.A1; also elsewhere on the board
/Input Output/BP1: D4.1 (K1), J3.1, U5.2
/Input Output/BP2: D4.3 (K2), J3.3, U5.4
/Input Output/BP3: D4.4 (K3), J3.5, U5.6
/Input Output/BP4: D4.5 (K4), J3.7, U5.8
BP1_µC: C15.1, R22.1, U5.16; also elsewhere on the board
BP2_µC: C17.1, R25.1, U5.14; also elsewhere on the board
BP3_µC: C18.1, R29.1, U5.12; also elsewhere on the board
BP4_µC: C19.1, R32.1, U5.10; also elsewhere on the board
BUZZER: R39.1; also elsewhere on the board
GND: C14.2, C15.2, C16.2, C17.2, C18.2, C19.2, D4.2 (A), J3.2, J3.4, J3.6, J3.8, J5.2, J5.4, J5.6, J6.5, J6.8, J6.10, Q4.2, Q5.2, Q6.2, Q7.2, R40.2, R41.2, R42.2, R43.2, U4.9, U4.11, U4.13, U4.15, U5.9, U5.11, U5.13, U5.15; also elsewhere on the board
IN1_418: J5.1, J6.9, U4.16
IN2_418: J5.3, J6.7, U4.14
IN3_418: J5.5, J6.6, U4.12
LD1: D5.1 (K), U4.10
unnamed: BZ1.2 (-), Q7.3
unnamed: D5.2 (A), R26.2
unnamed: D6.2 (A), K2.A2, R33.1
unnamed: D7.2 (A), K3.A2, R34.1
unnamed: D8.2 (A), K4.A2, R35.1
unnamed: Q4.1, R36.2, R40.1
unnamed: Q4.3, R33.2
unnamed: Q5.1, R37.1, R41.1
unnamed: Q5.3, R34.2
unnamed: Q6.1, R38.2, R42.1
unnamed: Q6.3, R35.2
unnamed: Q7.1, R39.2, R43.1
unnamed: R20.2, U4.1
unnamed: R21.2, U5.1
unnamed: R23.2, U4.3
unnamed: R24.2, U5.3
unnamed: R27.2, U4.5
unnamed: R28.2, U5.5
unnamed: R30.2, U4.7
unnamed: R31.2, U5.7
OUT1_418: J4.2, J6.3
OUT2_418: J4.4, J6.2
OUT3_418: J4.6, J6.1
OUT_IN1_418: U4.2; also elsewhere on the board
OUT_IN2_418: U4.4; also elsewhere on the board
OUT_IN3_418: U4.6; also elsewhere on the board
cmd_OUT1_418: R36.1; also elsewhere on the board
cmd_OUT2_418: R37.2; also elsewhere on the board
cmd_OUT3_418: R38.1; also elsewhere on the board
µC_LD1: U4.8; also elsewhere on the board

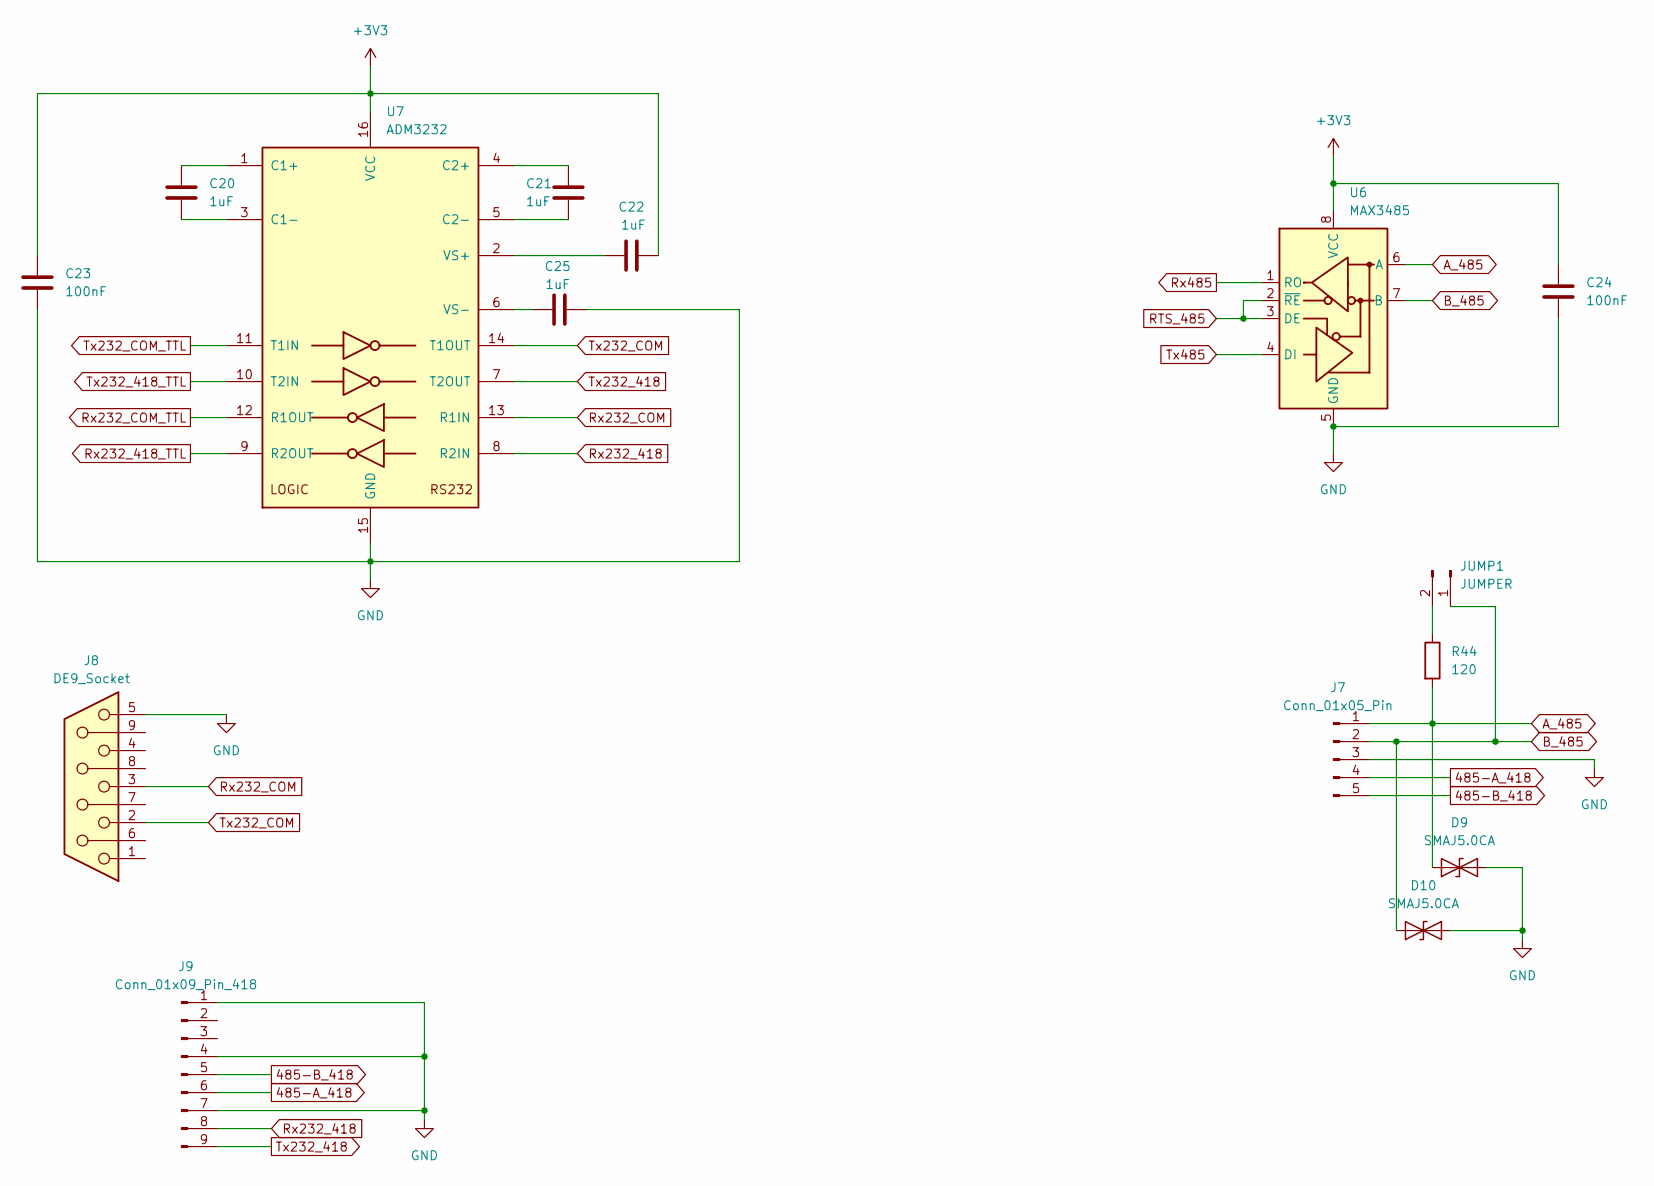
[picture p35: schematic com_RS232_485.kicad_sch, com RS232-485]

Parts:
C20, C21, C22, C25: 1uF; C_0805_2012Metric_Pad1.18x1.45mm_HandSolder
C23, C24: 100nF; C_0805_2012Metric_Pad1.18x1.45mm_HandSolder
D9, D10: SMAJ5.0CA; D_SMA
J7: Conn_01x05_Pin; PhoenixContact_MCV_1,5_5-G-3.81_1x05_P3.81mm_Vertical
J8: DE9_Socket; DSUB-9_Socket_Horizontal_P2.77x2.84mm_EdgePinOffset7.70mm_H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
J9: Conn_01x09_Pin_418; PhoenixContact_MCV_1,5_9-G-3.81_1x09_P3.81mm_Vertical
JUMP1: JUMPER; PinHeader_1x02_P2.54mm_Vertical
R44: 120; R_0805_2012Metric_Pad1.20x1.40mm_HandSolder
U6: MAX3485; SOIC-8_3.9x4.9mm_P1.27mm
U7: ADM3232; SOP-16_4.4x10.4mm_P1.27mm

Connections:
485-A_418: J7.4, J9.6
485-B_418: J7.5, J9.5
+3V3: C22.2, C23.1, C24.1, U6.8 (VCC), U7.16 (VCC); also elsewhere on the board
A_485: D9.1 (A1), J7.1, R44.2, U6.6 (A)
B_485: D10.1 (A1), J7.2, JUMP1.1, U6.7 (B)
GND: C23.2, C24.2, C25.2, D9.2 (A2), D10.2 (A2), J7.3, J8.5, J9.1, J9.4, J9.7, U6.5 (GND), U7.15 (GND); also elsewhere on the board
unnamed: JUMP1.2, R44.1
unnamed: C20.1, U7.1 (C1+)
unnamed: C20.2, U7.3 (C1-)
unnamed: C21.1, U7.4 (C2+)
unnamed: C21.2, U7.5 (C2-)
unnamed: C22.1, U7.2 (VS+)
unnamed: C25.1, U7.6 (VS-)
RTS_485: U6.2 (~RE), U6.3 (DE); also elsewhere on the board
Rx232_418: J9.8, U7.8 (R2IN)
Rx232_418_TTL: U7.9 (R2OUT); also elsewhere on the board
Rx232_COM: J8.3, U7.13 (R1IN)
Rx232_COM_TTL: U7.12 (R1OUT); also elsewhere on the board
Rx485: U6.1 (RO); also elsewhere on the board
Tx232_418: J9.9, U7.7 (T2OUT)
Tx232_418_TTL: U7.10 (T2IN); also elsewhere on the board
Tx232_COM: J8.2, U7.14 (T1OUT)
Tx232_COM_TTL: U7.11 (T1IN); also elsewhere on the board
Tx485: U6.4 (DI); also elsewhere on the board

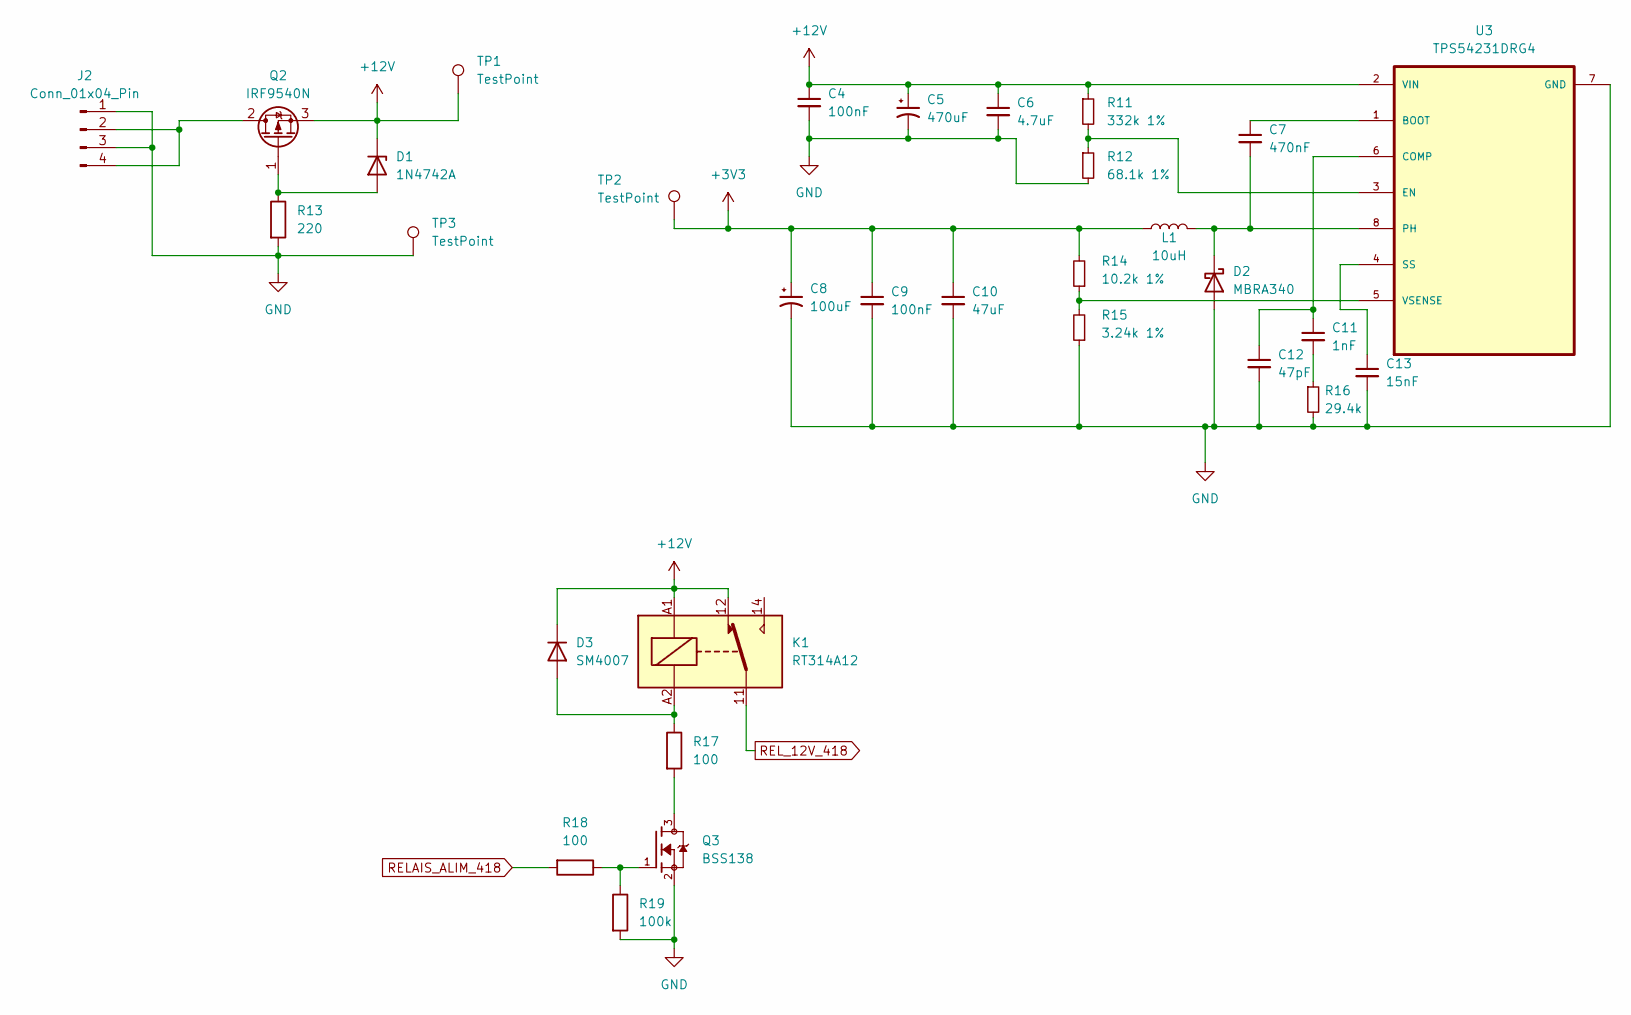
[picture p36: schematic untitled.kicad_sch, Alim]

Parts:
C4, C9: 100nF; C_0805_2012Metric_Pad1.18x1.45mm_HandSolder
C5: 470uF; C_Elec_10x10.2
C6: 4.7uF; C_1210_3225Metric_Pad1.33x2.70mm_HandSolder
C7: 470nF; C_0805_2012Metric_Pad1.18x1.45mm_HandSolder
C8: 100uF; CP_Elec_6.3x9.9
C10: 47uF; C_1210_3225Metric_Pad1.33x2.70mm_HandSolder
C11: 1nF; C_0805_2012Metric_Pad1.18x1.45mm_HandSolder
C12: 47pF; C_0805_2012Metric_Pad1.18x1.45mm_HandSolder
C13: 15nF; C_0805_2012Metric_Pad1.18x1.45mm_HandSolder
D1: 1N4742A; D_DO-41_SOD81_P10.16mm_Horizontal
D2: MBRA340; D_SMA
D3: SM4007; D_MELF
J2: Conn_01x04_Pin; PhoenixContact_MCV_1,5_4-G-3.81_1x04_P3.81mm_Vertical
K1: RT314A12; Relay_SPDT_Schrack-RT1-16A-FormC_RM5mm
L1: 10uH; L_Coilcraft_MOS6020-XXX
Q2: IRF9540N; TO-252-2
Q3: BSS138; SOT95P240X111-3N; PARTREV 30 Jan 2018
R11: 332k 1%; R_0805_2012Metric_Pad1.20x1.40mm_HandSolder
R12: 68.1k 1%; R_0805_2012Metric_Pad1.20x1.40mm_HandSolder
R13: 220; R_0805_2012Metric_Pad1.20x1.40mm_HandSolder
R14: 10.2k 1%; R_0805_2012Metric_Pad1.20x1.40mm_HandSolder
R15: 3.24k 1%; R_0805_2012Metric_Pad1.20x1.40mm_HandSolder
R16: 29.4k; R_0805_2012Metric_Pad1.20x1.40mm_HandSolder
R17, R18: 100; R_0805_2012Metric_Pad1.20x1.40mm_HandSolder
R19: 100k; R_0805_2012Metric_Pad1.20x1.40mm_HandSolder
TP1, TP2: TestPoint; TestPoint_Pad_1.5x1.5mm
TP3: TestPoint; TestPoint_Loop_D2.50mm_Drill1.85mm
U3: TPS54231DRG4; SOIC127P599X175-8N; DigiKey_Part_Number 296-52801-2-ND

Connections:
+3V3: C8.1, C9.1, C10.1, L1.1, R14.2, TP2.1; also elsewhere on the board
+12V: C4.1, C5.1, C6.1, D1.1 (K), D3.1 (K), K1.12, K1.A1, Q2.3 (S), R11.1, TP1.1, U3.2 (VIN); also elsewhere on the board
GND: C4.2, C5.2, C6.2, C8.2, C9.2, C10.2, C12.2, C13.2, D2.2 (A), J2.1, J2.3, Q3.2, R12.2, R13.2, R15.1, R16.2, R19.2, TP3.1, U3.7 (GND); also elsewhere on the board
unnamed: C11.2, R16.1
unnamed: D1.2 (A), Q2.1 (G), R13.1
unnamed: C7.2, D2.1 (K), L1.2, U3.8 (PH)
unnamed: D3.2 (A), K1.A2, R17.1
unnamed: J2.2, J2.4, Q2.2 (D)
unnamed: Q3.1, R18.1, R19.1
unnamed: Q3.3, R17.2
unnamed: C7.1, U3.1 (BOOT)
unnamed: C11.1, C12.1, U3.6 (COMP)
unnamed: R11.2, R12.1, U3.3 (EN)
unnamed: C13.1, U3.4 (SS)
unnamed: R14.1, R15.2, U3.5 (VSENSE)
RELAIS_ALIM_418: R18.2; also elsewhere on the board
REL_12V_418: K1.11; also elsewhere on the board

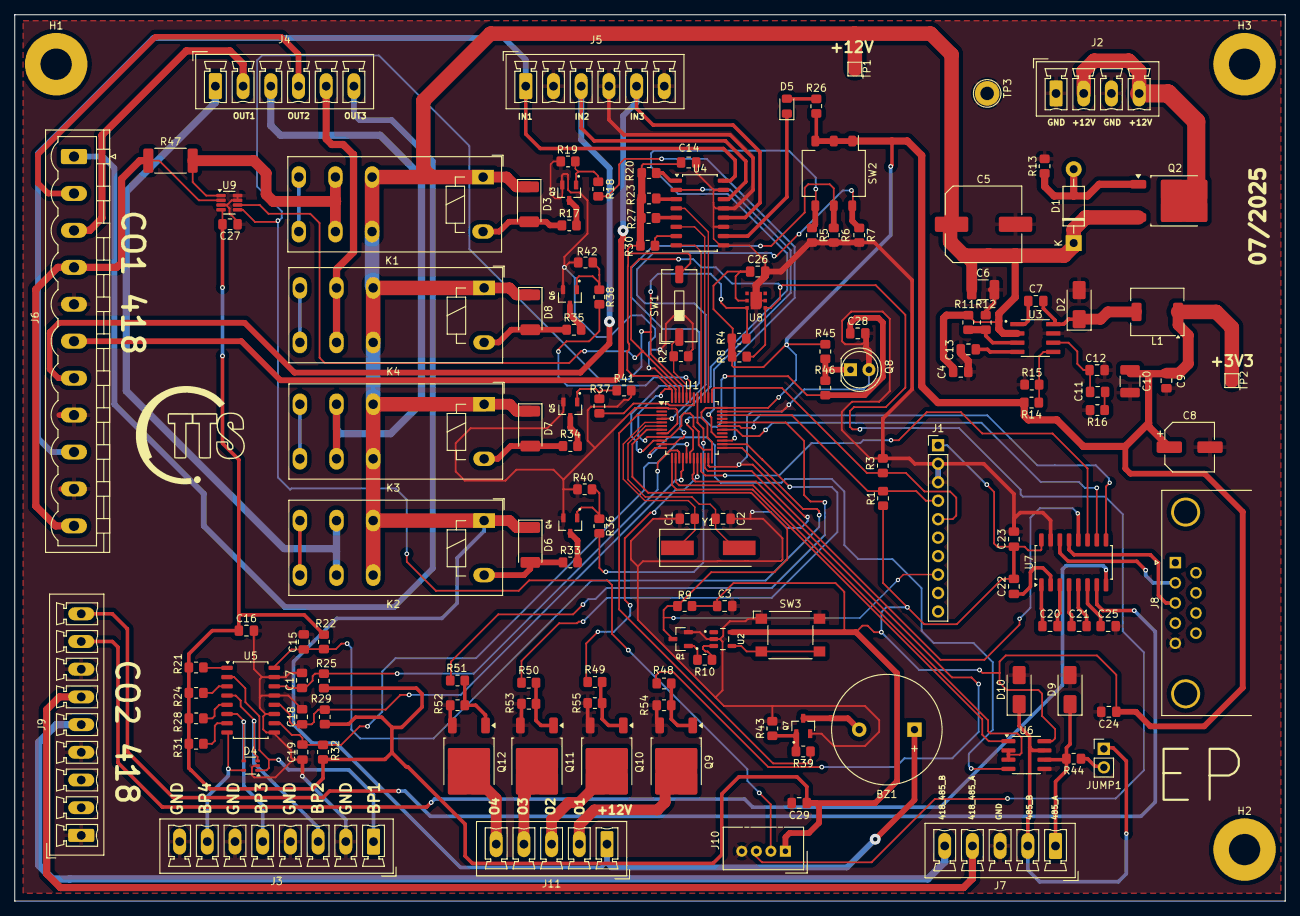
[picture p37: board BANC_TEST_418.kicad_pcb from above]

Board: 2 copper layers, 174.8 x 121.9 mm, 143 parts (0 on the bottom side), 114 nets.
