EnzoPerrier/BancTestEL418-Electronique/MCU/MCU.ioc

Mcu.UserName=STM32F103C8Tx
PA0-WKUP.GPIO_Label=DIP2
PA0-WKUP.Signal=GPIO_Input
PA1.GPIO_Label=DIP3
PA1.Signal=GPIO_Input
PA10.GPIO_Label=Rx232
PA10.Signal=USART1_RX
PA11.GPIO_Label=LED_CEL
PA11.Signal=GPIO_Output
PA13.GPIO_Label=SWDIO
PA13.Signal=SYS_JTMS-SWDIO
PA14.GPIO_Label=SWCLK
PA14.Signal=SYS_JTCK-SWCLK
PA15.GPIO_Label=OUT2
PA15.Signal=GPIO_Output
PA2.GPIO_Label=Tx485
PA2.Signal=USART2_TX
PA3.GPIO_Label=Rx485
PA3.Signal=USART2_RX
PA4.GPIO_Label=RTS_485
PA4.Signal=GPIO_Output
PA5.GPIO_Label=BP2
PA5.Signal=GPIO_Input
PA6.GPIO_Label=BP3
PA6.Signal=GPIO_Input
PA7.GPIO_Label=BP4
PA7.Signal=GPIO_Input
PA9.GPIO_Label=Tx232
PA9.Signal=USART1_TX
PB0.GPIO_Label=V_CEL
PB0.Signal=SharedAnalog_PB0
PB1.GPIO_Label=LEDR
PB1.Signal=GPIO_Output
PB10.GPIO_Label=TX_COM
PB10.Signal=USART3_TX
PB11.GPIO_Label=RX_COM
PB11.Signal=USART3_RX
PB12.GPIO_Label=BP1_IRQ
PB12.Signal=GPXTI12
PB13.GPIO_Label=LEDY
PB13.Signal=GPIO_Output
PB14.GPIO_Label=RELAIS_ALIM_418
PB14.Signal=GPIO_Output
PB15.GPIO_Label=OUT1
PB15.Signal=GPIO_Output
PB2.GPIO_Label=LEDG
PB2.Signal=GPIO_Output
PB3.GPIO_Label=OUT3
PB3.Signal=GPIO_Output
PB4.GPIO_Label=OUT4
PB4.Signal=GPIO_Output
PB5.GPIO_Label=OUT5
PB5.Signal=GPIO_Output
PB6.GPIO_Label=OUT6
PB6.Signal=GPIO_Output
PB7.GPIO_Label=OUT7
PB7.Signal=GPIO_Output
PB8.GPIO_Label=I2C_SCL
PB8.Signal=I2C1_SCL
PB9.GPIO_Label=I2C_SDA
PB9.Signal=I2C1_SDA
PC13-TAMPER-RTC.GPIO_Label=OUT8
PC13-TAMPER-RTC.Signal=GPIO_Output
PC14-OSC32_IN.GPIO_Label=BUZZER
PC14-OSC32_IN.Signal=GPIO_Output
PC15-OSC32_OUT.GPIO_Label=DIP1
PC15-OSC32_OUT.Signal=GPIO_Input
PD0-OSC_IN.Signal=RCC_OSC_IN
PD1-OSC_OUT.Signal=RCC_OSC_OUT
